Luhundun/TEC-5H/ReadMe.txt

project为工程文件
XX.HEX为微程序控制器烧写文件
ROM.HEX为ROM中代码烧写文件
报告.pdf中省去了本人信息
hex.py为本人写的将汇编烧写为hex文件的代码，只是顺序有点小差错``` 具体看一下就知道了，应该蛮好改的
