Luhundun/TEC-5H/(list of files, drawings)

Other design files:
project.pdsprj
